CopperPilot/rpi-zero-2w-kicad/docs/images/kicad-3d-isometric.png

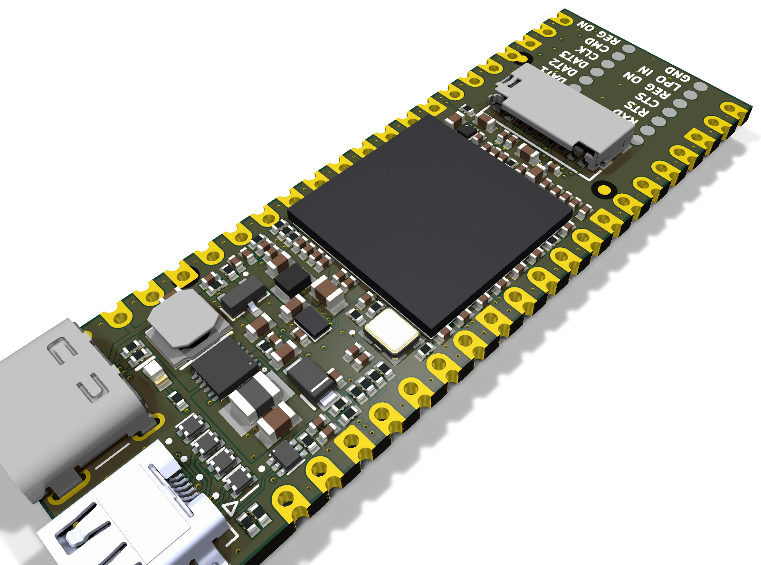
docs/images/kicad-3d-isometric.png
