CopperPilot/rpi-zero-2w-kicad/docs/images/kicad-3d-top-dnp.png

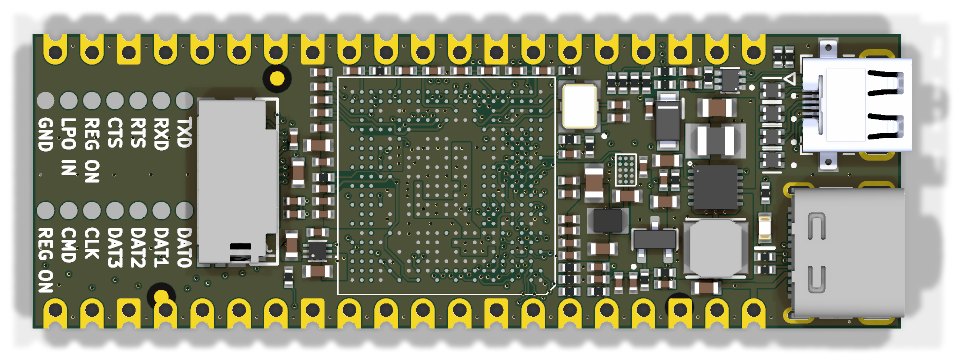
docs/images/kicad-3d-top-dnp.png
