CopperPilot/rpi-zero-2w-kicad/pcb/jlcpcb/rp3a0-mini-bom.csv

Comment | Designator | Footprint | JLCPCB Part #（optional）
220n | C1,C2,C5,C8,C18,C20,C21,C22,C23,C24,C26,C27,C28,C29,C30,C31,C32,C33,C34,C35,C37,C39,C40,C41,C42,C44,C45,C46 | 0402 | C16772
10u | C3,C4,C11,C13,C16,C17 | 0603 | C96446
30p | C6,C9 | 0402 | C1570
1u | C7,C10 | 0402 | C52923
47u | C12,C14 | C0805_NP | C16780
100n | C15,C19,C47 | 0402 | C1525
100p | C25 | 0402 | C1546
4.7u | C36,C38,C43 | 0603 | C1705
LED_GREEN | D1 | LED_0603 | C12624
DFLS130L-7 | D2 | DIO_DFLS130LQ-7 | C110493
EXC24CH900U | FL1,FL2,FL3,FL4 | FIL_EXC24CB102U | C236275
473092651 | J1 | MOLEX_0475710001 | C587826
467652301 | J2 | MOLEX_467652301 | C6961796
1054500101 | J3 | MOLEX_105450-0101 | C134092
470nH | L1 | INDC2016X100N | C89446
4.7uH | L2 | INDP4040X180N | C5926030
2.2uH | L3 | INDP2622X120N | C2041574
220R | L4,L5,L6 | 0402 | C85813
DMG2305UX-7 | Q1 | SOT91P240X110-3N_DMG2305UX-7 | C150470
1.8k | R1,R2,R21,R22,R23,R24 | RES-0402-SML | C25871
100k | R3,R19,R20 | RES-0402-SML | C25741
470k | R4 | RES-0402-SML | C25790
82k | R5 | RES-0402-SML | C4142
10k | R6 | RES-0402-SML | C25744
47k | R7,R15,R25 | RES-0402-SML | C25792
18k | R8 | RES-0402-SML | C25762
5.1k | R9,R10 | RES-0402-SML | C25905
470R | R11 | RES-0402-SML | C25117
240R | R12,R13,R18 | RES-0402-SML | C114755
33R | R14 | RES-0402-SML | C25105
3.9k | R16 | RES-0402-SML | C51721
1k | R17 | RES-0402-SML | C11702
NCP133AMX125TCG | U2 | VREG_RT9081A_1BGQZA_2 | C603545
RT8088AWSC | U3 | 15B_WLCSP_1.31X2.11 | C5739348
PAM2306AYPKE | U4 | SON45P300X300X80-13N | C508236
DMN601VK-7 | U5 | SOT50P162X60-6N | C110498
19.2MHz | Y1 | XTAL_ECS-192-18-33-JGN-TR | C5380596
