CopperPilot/rpi-zero-2w-kicad/pcb/rp3a0-mini.kicad_pcb

## KiCad design pcb/rp3a0-mini.kicad_pcb (2026-10-23)

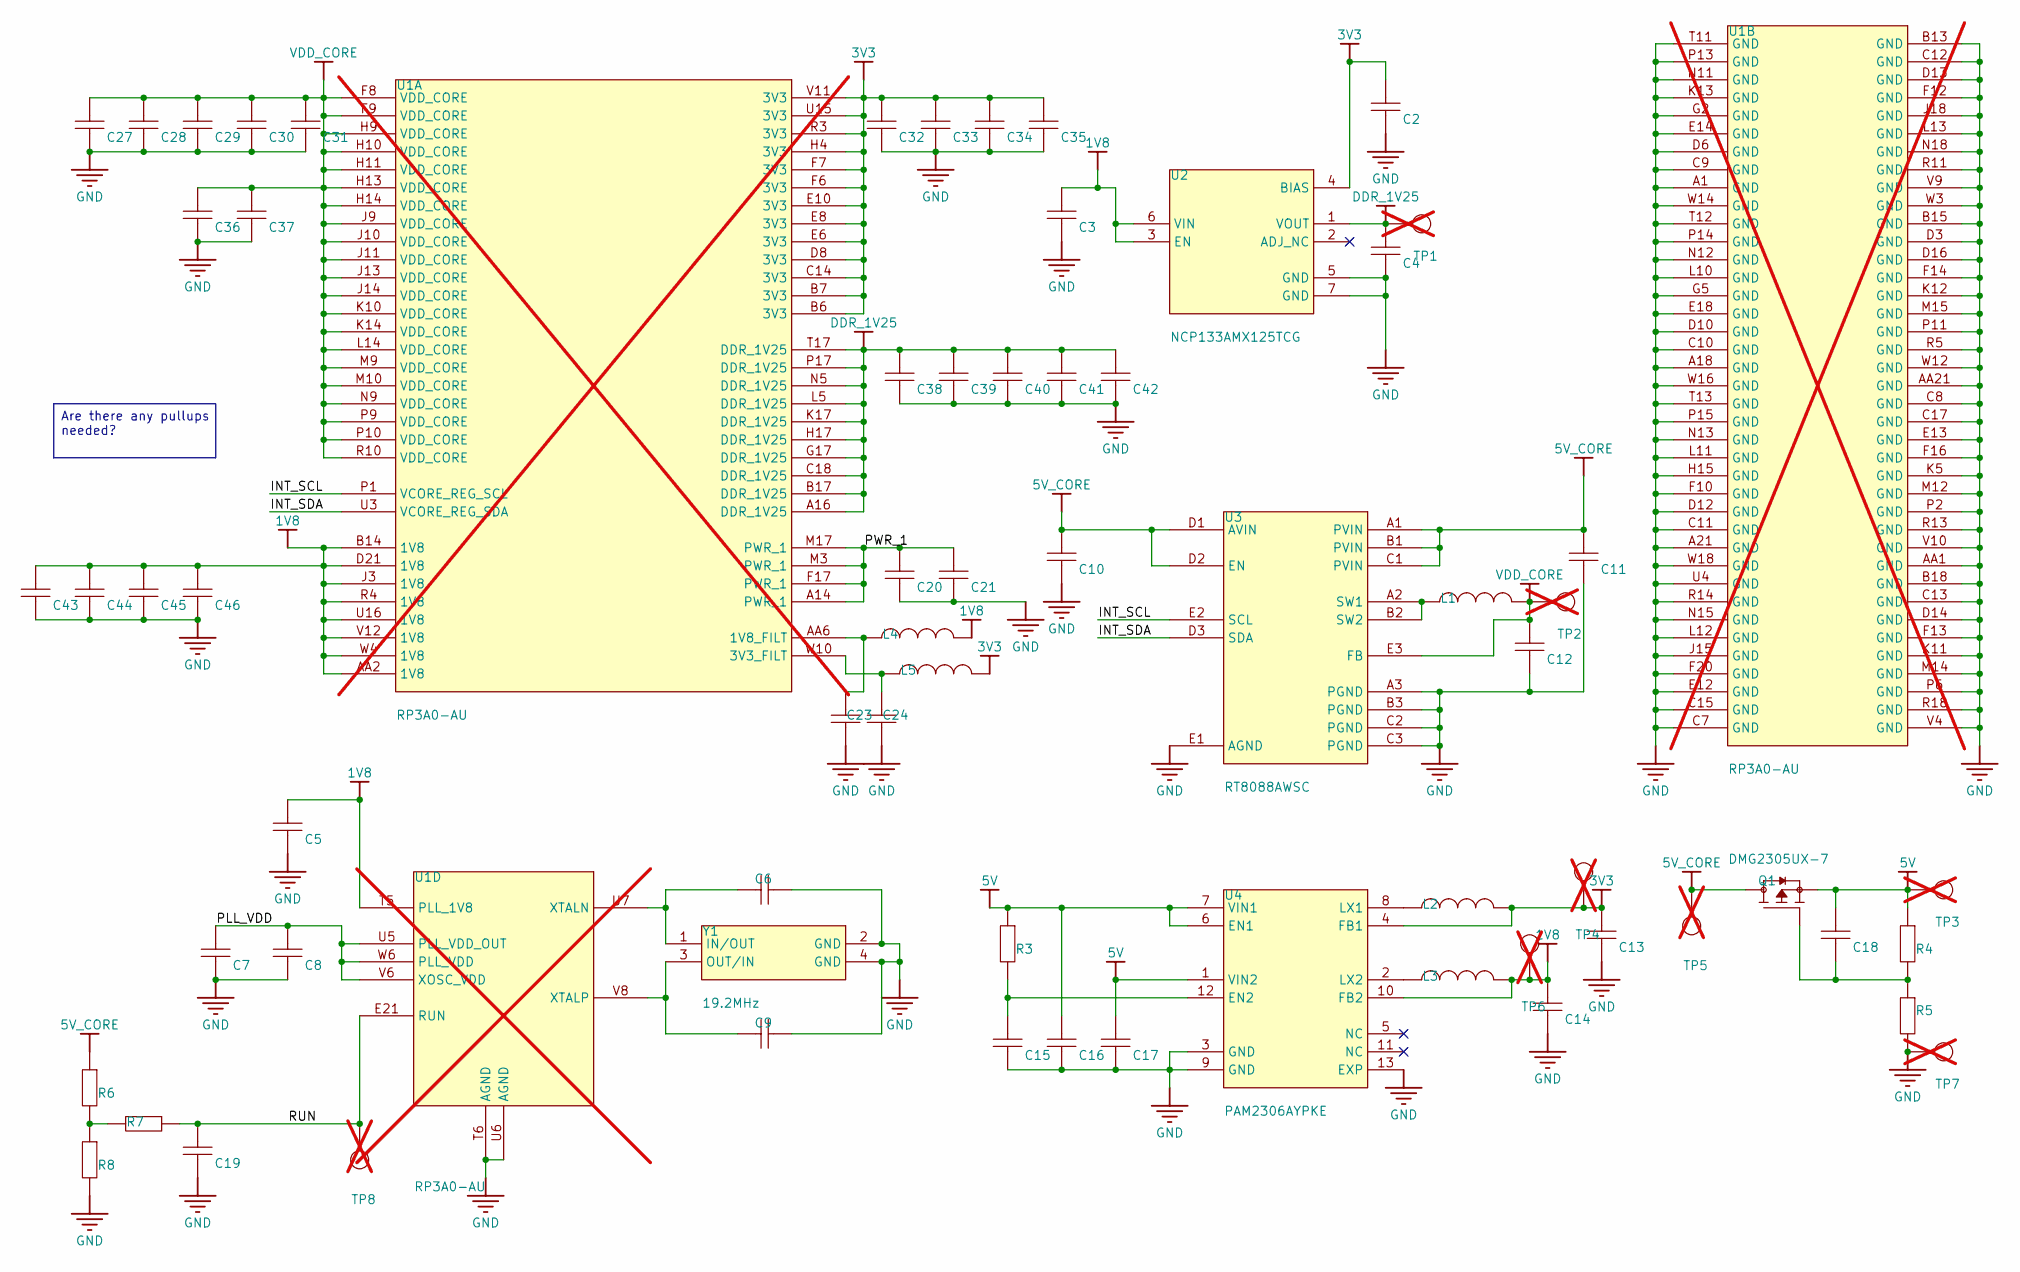
[picture p8: schematic rp3a-mini-power.kicad_sch, RP3A0 Pico - Power]

Parts:
C2, C5, C8, C18, C20, C21, C23, C24, C27, C28, C29, C30, C31, C32, C33, C34, C35, C37, C39, C40, C41, C42, C44, C45, C46: 220n; 0402; MPN CL05B224KO5NNNC; LCSC C16772
C3, C4, C11, C13, C16, C17: 10u; 0603; MPN CL10A106MA8NRNC; LCSC C96446
C6, C9: 30p; 0402; MPN 0402CG300J500NT; LCSC C1570
C7, C10: 1u; 0402; MPN CL05A105KA5NQNC; LCSC C52923
C12, C14: 47u; C0805_NP; MPN CL21A476MQYNNNE; LCSC C16780
C15, C19: 100n; 0402; MPN CL05B104KO5NNNC; LCSC C1525
C36, C38, C43: 4.7u; 0603; MPN CL10A475KP8NNNC; LCSC C1705
L1: 470nH; INDC2016X100N; MPN TFM201610GHM-R47MTAA; LCSC C89446
L2: 4.7uH; INDP4040X180N; MPN SRN4030HA-4R7Y; LCSC C5926030
L3: 2.2uH; INDP2622X120N; MPN SRN2512-2R2M; LCSC C2041574
L4, L5: 220R; 0402; MPN BLM15AG221SN1D; LCSC C85813
Q1: DMG2305UX-7; SOT91P240X110-3N_DMG2305UX-7; MPN DMG2305UX-7; LCSC C150470
R3: 100k; RES-0402-SML; MPN 0402WGF1003TCE; LCSC C25741
R4: 470k; RES-0402-SML; MPN 0402WGF4703TCE; LCSC C25790
R5: 82k; RES-0402-SML; MPN 0402WGF8202TCE; LCSC C4142
R6: 10k; RES-0402-SML; MPN 0402WGF1002TCE; LCSC C25744
R7: 47k; RES-0402-SML; MPN 0402WGF4702TCE; LCSC C25792
R8: 18k; RES-0402-SML; MPN 0402WGF1802TCE; LCSC C25762
TP1, TP2, TP3, TP4, TP5, TP6, TP7, TP8: TEST_POINT; TEST_POINT_1.2MM; MPN TEST_POINT_1.2MM; not fitted
U1: RP3A0-AU; RP3A0-BGA; MPN RP3A0-AU; not fitted
U2: NCP133AMX125TCG; VREG_RT9081A_1BGQZA_2; MPN NCP133AMX125TCG; LCSC C603545
U3: RT8088AWSC; 15B_WLCSP_1.31X2.11; MPN RT8088AWSC; LCSC C5739348
U4: PAM2306AYPKE; SON45P300X300X80-13N; MPN PAM2306AYPKE; LCSC C508236
Y1: 19.2MHz; XTAL_ECS-192-18-33-JGN-TR; MPN S3219200182080C3; LCSC C5380596

Connections:
1V8: C3.2, C5.2, C14.2, C43.2, C44.2, C45.2, C46.2, L3.2, L4.2, TP6.TP, U1.AA2 (1V8), U1.B14 (1V8), U1.D21 (1V8), U1.J3 (1V8), U1.R4 (1V8), U1.T5 (PLL_1V8), U1.U16 (1V8), U1.V12 (1V8), U1.W4 (1V8), U2.3 (EN), U2.6 (VIN), U4.10 (FB2)
3V3: C2.2, C13.2, C32.2, C33.2, C34.2, C35.2, L2.2, L5.2, TP4.TP, U1.B6 (3V3), U1.B7 (3V3), U1.C14 (3V3), U1.D8 (3V3), U1.E6 (3V3), U1.E8 (3V3), U1.E10 (3V3), U1.F6 (3V3), U1.F7 (3V3), U1.H4 (3V3), U1.R3 (3V3), U1.U15 (3V3), U1.V11 (3V3), U2.4 (BIAS), U4.4 (FB1); also elsewhere on the board
5V: C16.2, C17.2, C18.2, Q1.2 (S), R3.2, R4.2, TP3.TP, U4.1 (VIN2), U4.6 (EN1), U4.7 (VIN1); also elsewhere on the board
5V_CORE: C10.2, C11.2, Q1.3 (D), R6.2, TP5.TP, U3.A1 (PVIN), U3.B1 (PVIN), U3.C1 (PVIN), U3.D1 (AVIN), U3.D2 (EN)
/Power/INT_SCL: U1.P1 (VCORE_REG_SCL), U3.E2 (SCL)
/Power/INT_SDA: U1.U3 (VCORE_REG_SDA), U3.D3 (SDA)
/Power/PLL_VDD: C7.2, C8.2, U1.U5 (PLL_VDD_OUT), U1.V6 (XOSC_VDD), U1.W6 (PLL_VDD)
/Power/PWR_1: C20.2, C21.2, U1.A14 (PWR_1), U1.F17 (PWR_1), U1.M3 (PWR_1), U1.M17 (PWR_1)
/Power/RUN: C19.2, R7.2, TP8.TP, U1.E21 (RUN)
DDR_1V25: C4.2, C38.2, C39.2, C40.2, C41.2, C42.2, TP1.TP, U1.A16 (DDR_1V25), U1.B17 (DDR_1V25), U1.C18 (DDR_1V25), U1.G17 (DDR_1V25), U1.H17 (DDR_1V25), U1.K17 (DDR_1V25), U1.L5 (DDR_1V25), U1.N5 (DDR_1V25), U1.P17 (DDR_1V25), U1.T17 (DDR_1V25), U2.1 (VOUT)
GND: C2.1, C3.1, C4.1, C5.1, C6.2, C7.1, C8.1, C9.2, C10.1, C11.1, C12.1, C13.1, C14.1, C15.1, C16.1, C17.1, C19.1, C20.1, C21.1, C23.1, C24.1, C27.1, C28.1, C29.1, C30.1, C31.1, C32.1, C33.1, C34.1, C35.1, C36.1, C37.1, C38.1, C39.1, C40.1, C41.1, C42.1, C43.1, C44.1, C45.1, C46.1, R5.2, R8.1, TP7.TP, U1.A1 (GND), U1.A18 (GND), U1.A21 (GND), U1.AA1 (GND), U1.AA21 (GND), U1.B13 (GND), U1.B15 (GND), U1.B18 (GND), U1.C7 (GND), U1.C8 (GND), U1.C9 (GND), U1.C10 (GND), U1.C11 (GND), U1.C12 (GND), U1.C13 (GND), U1.C15 (GND), U1.C17 (GND), U1.D3 (GND), U1.D6 (GND), U1.D10 (GND), U1.D12 (GND), U1.D13 (GND), U1.D14 (GND), U1.D16 (GND), U1.E12 (GND), U1.E13 (GND), U1.E14 (GND), U1.E18 (GND), U1.F10 (GND), U1.F12 (GND), U1.F13 (GND), U1.F14 (GND), U1.F16 (GND), U1.F20 (GND), U1.G2 (GND), U1.G5 (GND), U1.H15 (GND), U1.J15 (GND), U1.J18 (GND), U1.K5 (GND), U1.K11 (GND), U1.K12 (GND), U1.K13 (GND), U1.L10 (GND), U1.L11 (GND), U1.L12 (GND), U1.L13 (GND), U1.M12 (GND), U1.M14 (GND), U1.M15 (GND), U1.N11 (GND), U1.N12 (GND), U1.N13 (GND), U1.N15 (GND), U1.N18 (GND), U1.P2 (GND), U1.P6 (GND), U1.P11 (GND), U1.P13 (GND), U1.P14 (GND), U1.P15 (GND), U1.R5 (GND), U1.R11 (GND), U1.R13 (GND), U1.R14 (GND), U1.R18 (GND), U1.T6 (AGND), U1.T11 (GND), U1.T12 (GND), U1.T13 (GND), U1.U4 (GND), U1.U6 (AGND), U1.V4 (GND), U1.V9 (GND), U1.V10 (GND), U1.W3 (GND), U1.W12 (GND), U1.W14 (GND), U1.W16 (GND), U1.W18 (GND), U2.5 (GND), U2.7 (GND), U3.A3 (PGND), U3.B3 (PGND), U3.C2 (PGND), U3.C3 (PGND), U3.E1 (AGND), U4.3 (GND), U4.9 (GND), U4.13 (EXP), Y1.2 (GND), Y1.4 (GND); also elsewhere on the board
unnamed: C18.1, Q1.1 (G), R4.1, R5.1
unnamed: R6.1, R7.1, R8.2
unnamed: C23.2, L4.1, U1.AA6 (1V8_FILT)
unnamed: C24.2, L5.1, U1.W10 (3V3_FILT)
unnamed: C6.1, U1.U7 (XTALN), Y1.1 (IN/OUT)
unnamed: C9.1, U1.V8 (XTALP), Y1.3 (OUT/IN)
unnamed: L1.1, U3.A2 (SW1), U3.B2 (SW2)
unnamed: C15.2, R3.1, U4.12 (EN2)
unnamed: L2.1, U4.8 (LX1)
unnamed: L3.1, U4.2 (LX2)
VDD_CORE: C12.2, C27.2, C28.2, C29.2, C30.2, C31.2, C36.2, C37.2, L1.2, TP2.TP, U1.F8 (VDD_CORE), U1.F9 (VDD_CORE), U1.H9 (VDD_CORE), U1.H10 (VDD_CORE), U1.H11 (VDD_CORE), U1.H13 (VDD_CORE), U1.H14 (VDD_CORE), U1.J9 (VDD_CORE), U1.J10 (VDD_CORE), U1.J11 (VDD_CORE), U1.J13 (VDD_CORE), U1.J14 (VDD_CORE), U1.K10 (VDD_CORE), U1.K14 (VDD_CORE), U1.L14 (VDD_CORE), U1.M9 (VDD_CORE), U1.M10 (VDD_CORE), U1.N9 (VDD_CORE), U1.P9 (VDD_CORE), U1.P10 (VDD_CORE), U1.R10 (VDD_CORE), U3.E3 (FB)

Notes on the sheet:
Are there any pullups needed?

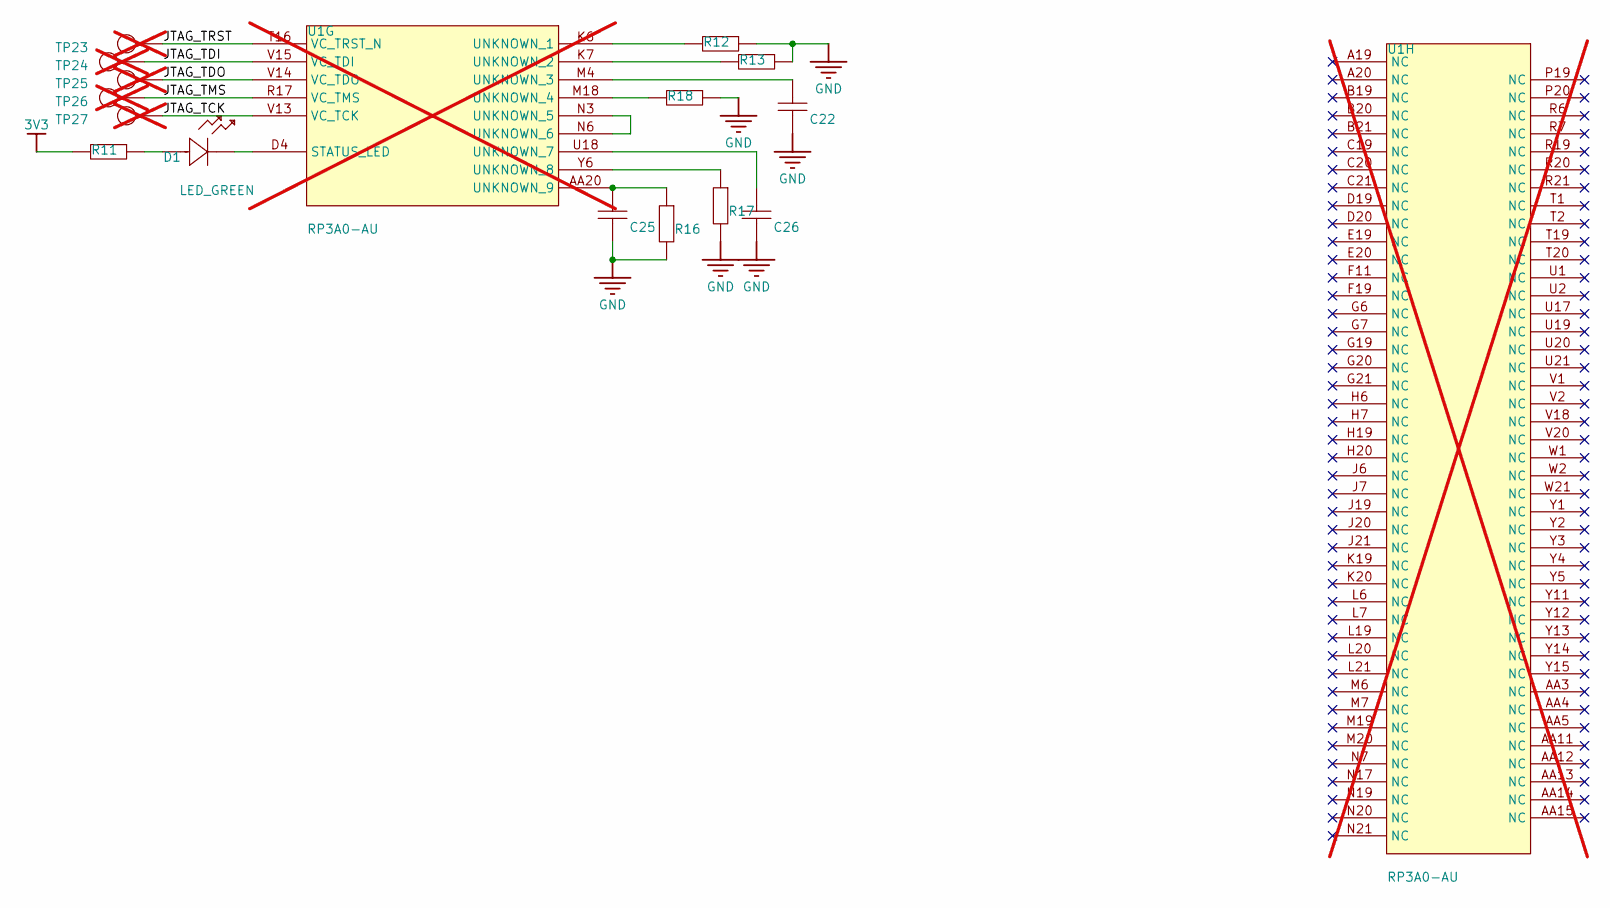
[picture p9: schematic rp3a0-mini-misc.kicad_sch, RP3A0 Pico - Misc_JTAG]

Parts:
C22, C26: 220n; 0402; MPN CL05B224KO5NNNC; LCSC C16772
C25: 100p; 0402; MPN 0402CG101J500NT; LCSC C1546
D1: LED_GREEN; LED_0603; MPN KT-0603G; LCSC C12624
R11: 470R; RES-0402-SML; MPN 0402WGF4700TCE; LCSC C25117
R12, R13, R18: 240R; RES-0402-SML; MPN RC0402FR-07240RL; LCSC C114755
R16: 3.9k; RES-0402-SML; MPN 0402WGF3901TCE; LCSC C51721
R17: 1k; RES-0402-SML; MPN 0402WGF1001TCE; LCSC C11702
TP23, TP24, TP25, TP26, TP27: TEST_POINT; TEST_POINT_1.2MM; MPN TEST_POINT_1.2MM; not fitted
U1: RP3A0-AU; RP3A0-BGA; MPN RP3A0-AU; not fitted

Connections:
3V3: R11.1; also elsewhere on the board
/Misc_JTAG/JTAG_TCK: TP27.TP, U1.V13 (VC_TCK)
/Misc_JTAG/JTAG_TDI: TP24.TP, U1.V15 (VC_TDI)
/Misc_JTAG/JTAG_TDO: TP25.TP, U1.V14 (VC_TDO)
/Misc_JTAG/JTAG_TMS: TP26.TP, U1.R17 (VC_TMS)
/Misc_JTAG/JTAG_TRST: TP23.TP, U1.T16 (VC_TRST_N)
GND: C22.1, C25.1, C26.1, R12.2, R13.2, R16.1, R17.1, R18.2; also elsewhere on the board
unnamed: D1.2, R11.2
unnamed: D1.1, U1.D4 (STATUS_LED)
unnamed: R12.1, U1.K6 (UNKNOWN_1)
unnamed: R13.1, U1.K7 (UNKNOWN_2)
unnamed: C22.2, U1.M4 (UNKNOWN_3)
unnamed: R18.1, U1.M18 (UNKNOWN_4)
unnamed: U1.N3 (UNKNOWN_5), U1.N6 (UNKNOWN_6)
unnamed: C26.2, U1.U18 (UNKNOWN_7)
unnamed: R17.2, U1.Y6 (UNKNOWN_8)
unnamed: C25.2, R16.2, U1.AA20 (UNKNOWN_9)

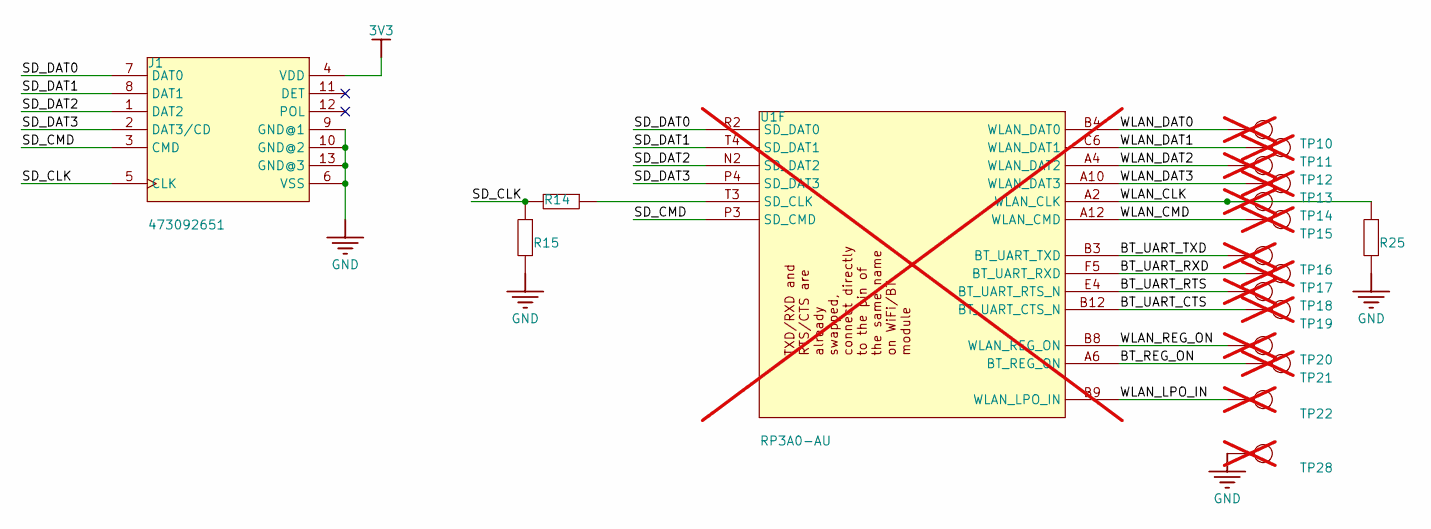
[picture p10: schematic rp3a0-mini-wireless-sd.kicad_sch, RP3A0 Pico - Wireless_SD]

Parts:
J1: 473092651; MOLEX_0475710001; MPN 473092651; LCSC C587826
R14: 33R; RES-0402-SML; MPN 0402WGF330JTCE; LCSC C25105
R15, R25: 47k; RES-0402-SML; MPN 0402WGF4702TCE; LCSC C25792
TP10, TP11, TP12, TP13, TP14, TP15, TP16, TP17, TP18, TP19, TP20, TP21, TP22, TP28: TEST_POINT; TEST_POINT_1.2MM; MPN TEST_POINT_1.2MM; not fitted
U1: RP3A0-AU; RP3A0-BGA; MPN RP3A0-AU; not fitted

Connections:
3V3: J1.4 (VDD); also elsewhere on the board
/Wireless_SD/BT_REG_ON: TP21.TP, U1.A6 (BT_REG_ON)
/Wireless_SD/BT_UART_CTS: TP19.TP, U1.B12 (BT_UART_CTS_N)
/Wireless_SD/BT_UART_RTS: TP18.TP, U1.E4 (BT_UART_RTS_N)
/Wireless_SD/BT_UART_RXD: TP17.TP, U1.F5 (BT_UART_RXD)
/Wireless_SD/BT_UART_TXD: TP16.TP, U1.B3 (BT_UART_TXD)
/Wireless_SD/SD_CLK: J1.5 (CLK), R14.1, R15.2
/Wireless_SD/SD_CMD: J1.3 (CMD), U1.P3 (SD_CMD)
/Wireless_SD/SD_DAT0: J1.7 (DAT0), U1.R2 (SD_DAT0)
/Wireless_SD/SD_DAT1: J1.8 (DAT1), U1.T4 (SD_DAT1)
/Wireless_SD/SD_DAT2: J1.1 (DAT2), U1.N2 (SD_DAT2)
/Wireless_SD/SD_DAT3: J1.2 (DAT3/CD), U1.P4 (SD_DAT3)
/Wireless_SD/WLAN_CLK: R25.2, TP14.TP, U1.A2 (WLAN_CLK)
/Wireless_SD/WLAN_CMD: TP15.TP, U1.A12 (WLAN_CMD)
/Wireless_SD/WLAN_DAT0: TP10.TP, U1.B4 (WLAN_DAT0)
/Wireless_SD/WLAN_DAT1: TP11.TP, U1.C6 (WLAN_DAT1)
/Wireless_SD/WLAN_DAT2: TP12.TP, U1.A4 (WLAN_DAT2)
/Wireless_SD/WLAN_DAT3: TP13.TP, U1.A10 (WLAN_DAT3)
/Wireless_SD/WLAN_LPO_IN: TP22.TP, U1.B9 (WLAN_LPO_IN)
/Wireless_SD/WLAN_REG_ON: TP20.TP, U1.B8 (WLAN_REG_ON)
GND: J1.6 (VSS), J1.9 (GND@1), J1.10 (GND@2), J1.13 (GND@3), R15.1, R25.1, TP28.TP; also elsewhere on the board
unnamed: R14.2, U1.T3 (SD_CLK)

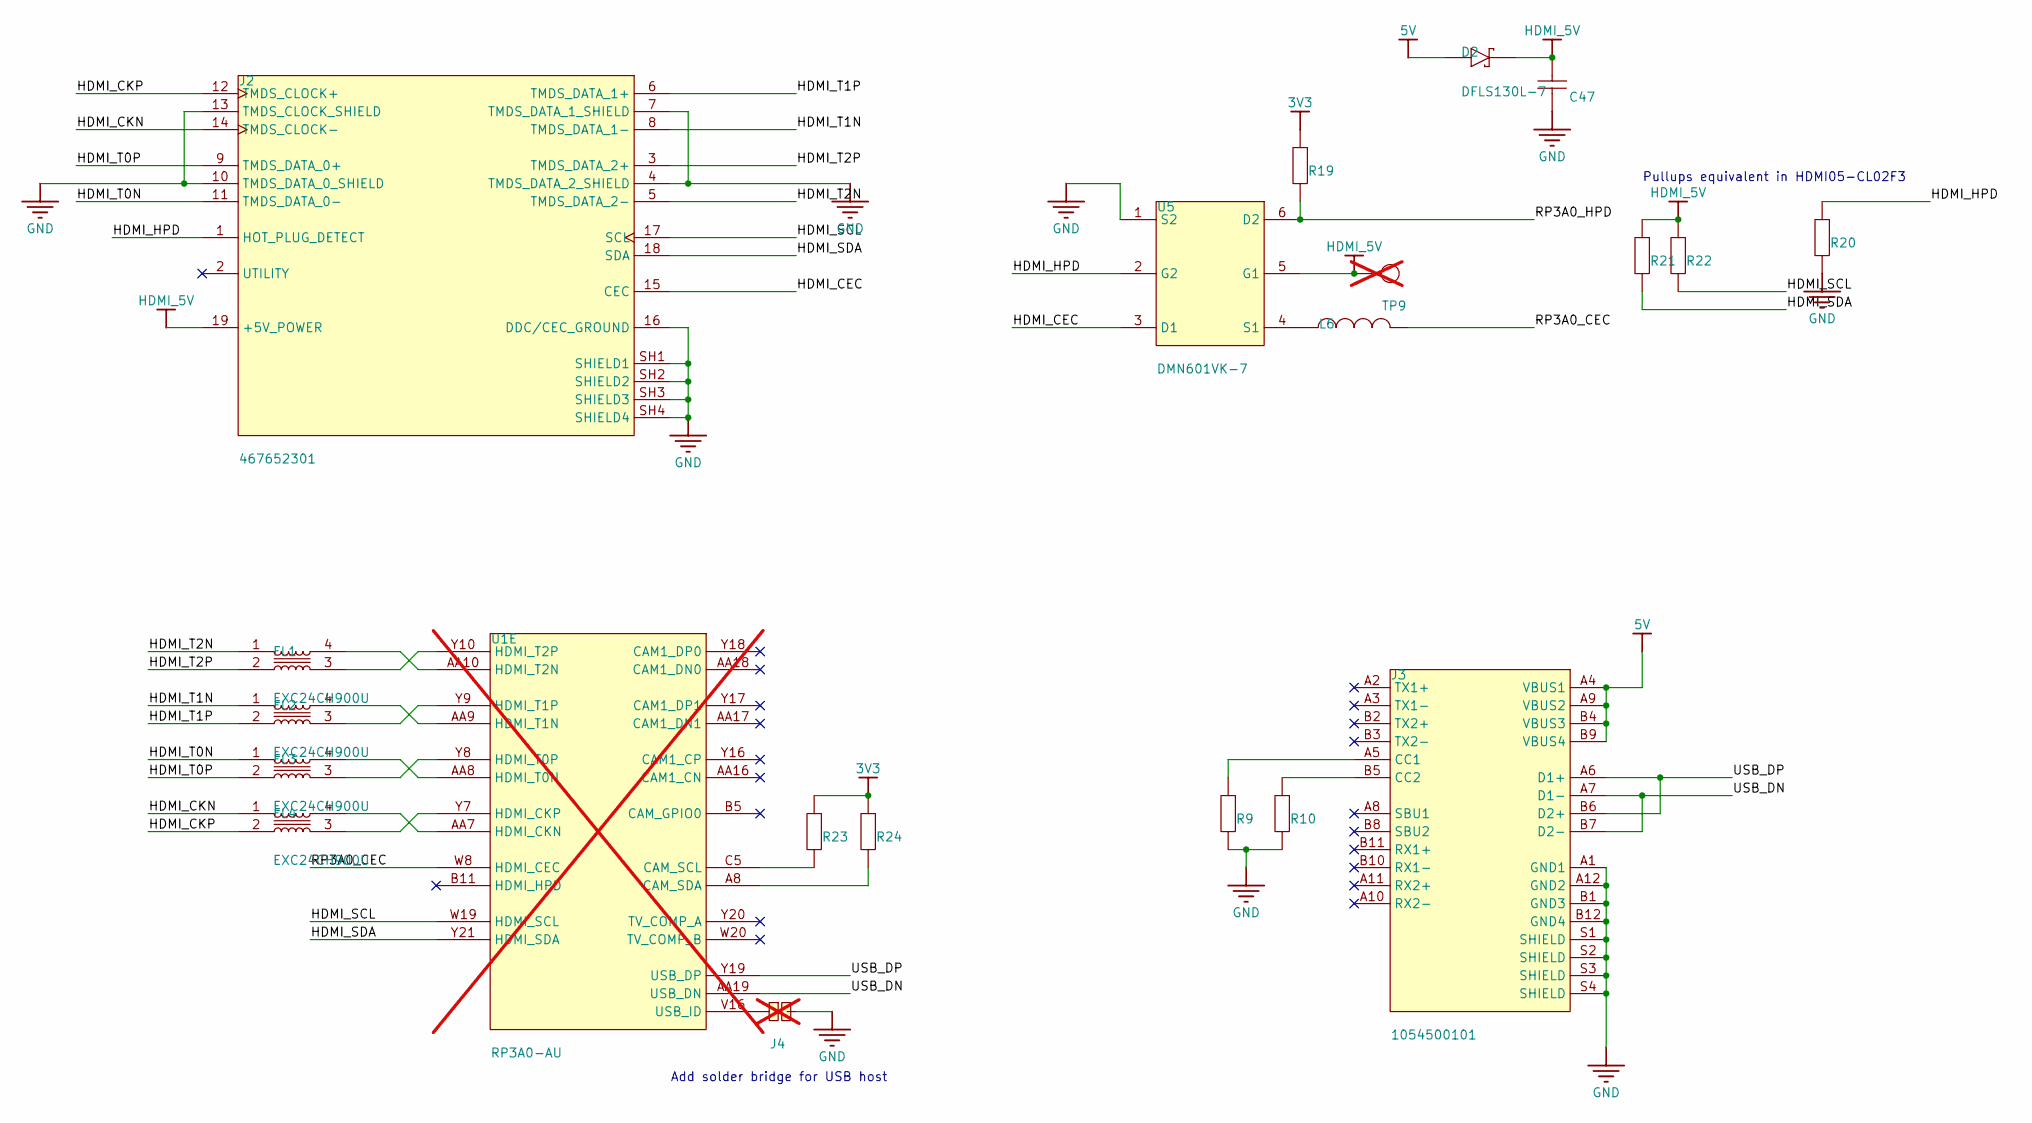
[picture p11: schematic rp3a0-mini-hdmi.kicad_sch, RP3A0 Pico - HDMI_USB]

Parts:
C47: 100n; 0402; MPN CL05B104KO5NNNC; LCSC C1525
D2: DFLS130L-7; DIO_DFLS130LQ-7; MPN DFLS130L-7; LCSC C110493
FL1, FL2, FL3, FL4: EXC24CH900U; FIL_EXC24CB102U; MPN EXC24CH900U; LCSC C236275
J2: 467652301; MOLEX_467652301; MPN 467652301; LCSC C6961796
J3: 1054500101; MOLEX_105450-0101; MPN 1054500101; DIGI-KEY_PART_NUMBER WM12856CT-ND
J4: SOLDER_PAD_OPEN; MPN SOLDER_PAD_OPEN; not fitted
L6: 220R; 0402; MPN BLM15AG221SN1D; LCSC C85813
R9, R10: 5.1k; RES-0402-SML; MPN 0402WGF5101TCE; LCSC C25905
R19, R20: 100k; RES-0402-SML; MPN 0402WGF1003TCE; LCSC C25741
R21, R22, R23, R24: 1.8k; RES-0402-SML; MPN 0402WGF1801TCE; LCSC C25871
TP9: TEST_POINT; TEST_POINT_1.2MM; MPN TEST_POINT_1.2MM; not fitted
U1: RP3A0-AU; RP3A0-BGA; MPN RP3A0-AU; not fitted
U5: DMN601VK-7; SOT50P162X60-6N; MPN DMN601VK-7; LCSC C110498

Connections:
3V3: R19.2, R23.2, R24.2; also elsewhere on the board
5V: D2.A, J3.A4 (VBUS1), J3.A9 (VBUS2), J3.B4 (VBUS3), J3.B9 (VBUS4); also elsewhere on the board
/HDMI_USB/HDMI_CEC: J2.15 (CEC), U5.3 (D1)
/HDMI_USB/HDMI_CKN: FL4.1, J2.14 (TMDS_CLOCK-)
/HDMI_USB/HDMI_CKP: FL4.2, J2.12 (TMDS_CLOCK+)
/HDMI_USB/HDMI_HPD: J2.1 (HOT_PLUG_DETECT), R20.2, U5.2 (G2)
/HDMI_USB/HDMI_SCL: J2.17 (SCL), R22.1, U1.W19 (HDMI_SCL)
/HDMI_USB/HDMI_SDA: J2.18 (SDA), R21.1, U1.Y21 (HDMI_SDA)
/HDMI_USB/HDMI_T0N: FL3.1, J2.11 (TMDS_DATA_0-)
/HDMI_USB/HDMI_T0P: FL3.2, J2.9 (TMDS_DATA_0+)
/HDMI_USB/HDMI_T1N: FL2.1, J2.8 (TMDS_DATA_1-)
/HDMI_USB/HDMI_T1P: FL2.2, J2.6 (TMDS_DATA_1+)
/HDMI_USB/HDMI_T2N: FL1.1, J2.5 (TMDS_DATA_2-)
/HDMI_USB/HDMI_T2P: FL1.2, J2.3 (TMDS_DATA_2+)
/HDMI_USB/RP3A0_CEC: L6.2, U1.W8 (HDMI_CEC)
/HDMI_USB/RP3A0_HPD: R19.1, U5.6 (D2)
/HDMI_USB/USB_DN: J3.A7 (D1-), J3.B7 (D2-), U1.AA19 (USB_DN)
/HDMI_USB/USB_DP: J3.A6 (D1+), J3.B6 (D2+), U1.Y19 (USB_DP)
GND: C47.1, J2.4 (TMDS_DATA_2_SHIELD), J2.7 (TMDS_DATA_1_SHIELD), J2.10 (TMDS_DATA_0_SHIELD), J2.13 (TMDS_CLOCK_SHIELD), J2.16 (DDC/CEC_GROUND), J2.SH1 (SHIELD1), J2.SH2 (SHIELD2), J2.SH3 (SHIELD3), J2.SH4 (SHIELD4), J3.A1 (GND1), J3.A12 (GND2), J3.B1 (GND3), J3.B12 (GND4), J3.S1 (SHIELD), J3.S2 (SHIELD), J3.S3 (SHIELD), J3.S4 (SHIELD), J4.2, R9.1, R10.1, R20.1, U5.1 (S2); also elsewhere on the board
HDMI_5V: C47.2, D2.K, J2.19 (+5V_POWER), R21.2, R22.2, TP9.TP, U5.5 (G1)
unnamed: J3.A5 (CC1), R9.2
unnamed: J3.B5 (CC2), R10.2
unnamed: R23.1, U1.C5 (CAM_SCL)
unnamed: R24.1, U1.A8 (CAM_SDA)
unnamed: FL4.4, U1.AA7 (HDMI_CKN)
unnamed: FL4.3, U1.Y7 (HDMI_CKP)
unnamed: FL3.4, U1.AA8 (HDMI_T0N)
unnamed: FL3.3, U1.Y8 (HDMI_T0P)
unnamed: FL2.4, U1.AA9 (HDMI_T1N)
unnamed: FL2.3, U1.Y9 (HDMI_T1P)
unnamed: FL1.4, U1.AA10 (HDMI_T2N)
unnamed: FL1.3, U1.Y10 (HDMI_T2P)
unnamed: J4.1, U1.V16 (USB_ID)
unnamed: L6.1, U5.4 (S1)

Notes on the sheet:
Pullups equivalent in HDMI05-CL02F3
Add solder bridge for USB host

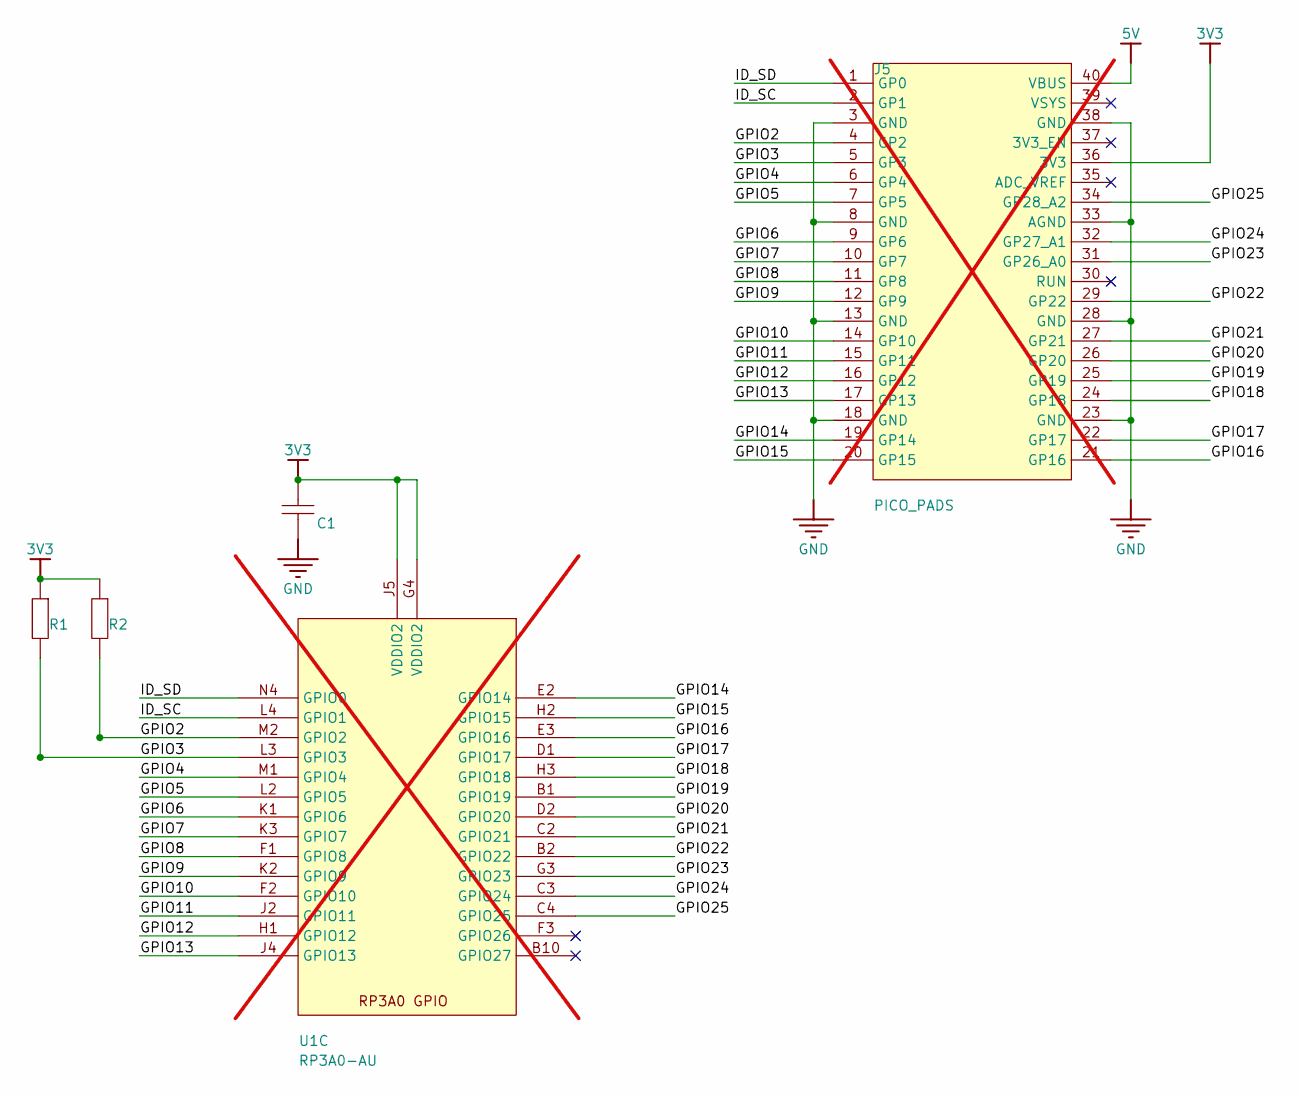
[picture p12: schematic rp3a0-mini-gpio.kicad_sch, RP3A0 Pico - GPIO]

Parts:
C1: 220n; 0402; MPN CL05B224KO5NNNC; LCSC C16772
J5: PICO_PADS; MPN PICO_PADS; not fitted
R1, R2: 1.8k; RES-0402-SML; MPN 0402WGF1801TCE; LCSC C25871
U1: RP3A0-AU; RP3A0-BGA; MPN RP3A0-AU; not fitted

Connections:
3V3: C1.2, J5.36 (3V3), R1.2, R2.2, U1.G4 (VDDIO2), U1.J5 (VDDIO2); also elsewhere on the board
5V: J5.40 (VBUS); also elsewhere on the board
/GPIO/GPIO2: J5.4 (GP2), R2.1, U1.M2 (GPIO2)
/GPIO/GPIO3: J5.5 (GP3), R1.1, U1.L3 (GPIO3)
/GPIO/GPIO4: J5.6 (GP4), U1.M1 (GPIO4)
/GPIO/GPIO5: J5.7 (GP5), U1.L2 (GPIO5)
/GPIO/GPIO6: J5.9 (GP6), U1.K1 (GPIO6)
/GPIO/GPIO7: J5.10 (GP7), U1.K3 (GPIO7)
/GPIO/GPIO8: J5.11 (GP8), U1.F1 (GPIO8)
/GPIO/GPIO9: J5.12 (GP9), U1.K2 (GPIO9)
/GPIO/GPIO10: J5.14 (GP10), U1.F2 (GPIO10)
/GPIO/GPIO11: J5.15 (GP11), U1.J2 (GPIO11)
/GPIO/GPIO12: J5.16 (GP12), U1.H1 (GPIO12)
/GPIO/GPIO13: J5.17 (GP13), U1.J4 (GPIO13)
/GPIO/GPIO14: J5.19 (GP14), U1.E2 (GPIO14)
/GPIO/GPIO15: J5.20 (GP15), U1.H2 (GPIO15)
/GPIO/GPIO16: J5.21 (GP16), U1.E3 (GPIO16)
/GPIO/GPIO17: J5.22 (GP17), U1.D1 (GPIO17)
/GPIO/GPIO18: J5.24 (GP18), U1.H3 (GPIO18)
/GPIO/GPIO19: J5.25 (GP19), U1.B1 (GPIO19)
/GPIO/GPIO20: J5.26 (GP20), U1.D2 (GPIO20)
/GPIO/GPIO21: J5.27 (GP21), U1.C2 (GPIO21)
/GPIO/GPIO22: J5.29 (GP22), U1.B2 (GPIO22)
/GPIO/GPIO23: J5.31 (GP26_A0), U1.G3 (GPIO23)
/GPIO/GPIO24: J5.32 (GP27_A1), U1.C3 (GPIO24)
/GPIO/GPIO25: J5.34 (GP28_A2), U1.C4 (GPIO25)
/GPIO/ID_SC: J5.2 (GP1), U1.L4 (GPIO1)
/GPIO/ID_SD: J5.1 (GP0), U1.N4 (GPIO0)
GND: C1.1, J5.3 (GND), J5.8 (GND), J5.13 (GND), J5.18 (GND), J5.23 (GND), J5.28 (GND), J5.33 (AGND), J5.38 (GND); also elsewhere on the board

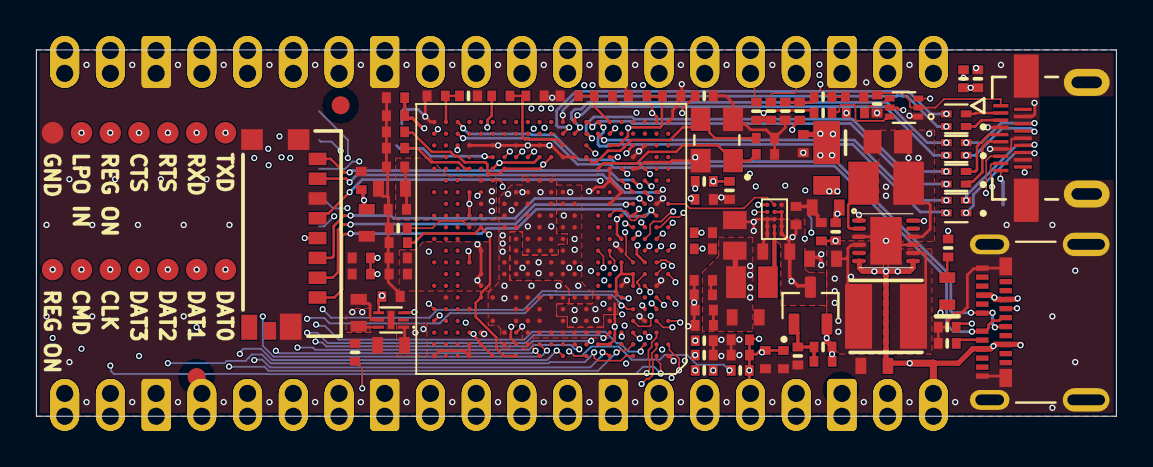
[picture p13: board rp3a0-mini.kicad_pcb from above]

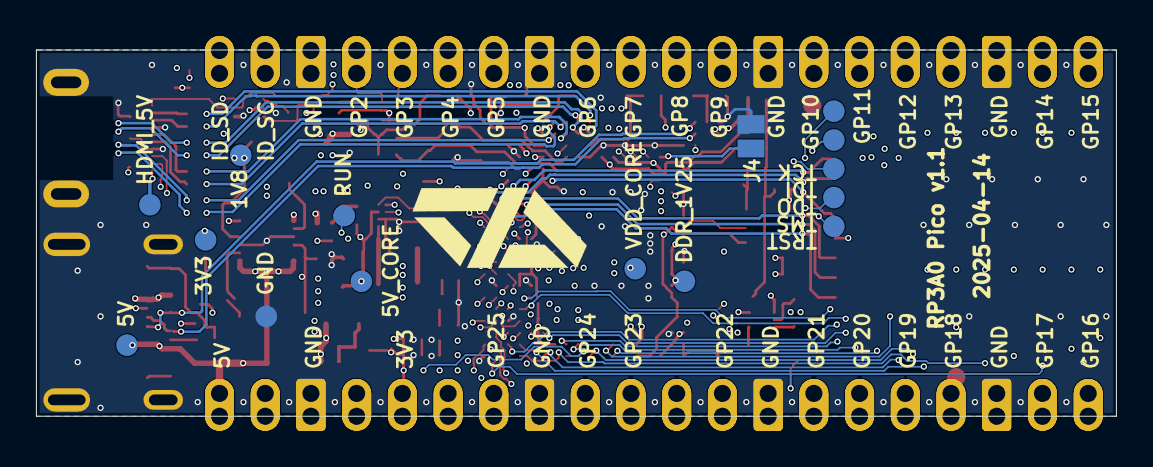
[picture p14: board rp3a0-mini.kicad_pcb from below]

Board: 6 copper layers, 60.0 x 20.4 mm, 124 parts (15 on the bottom side), 114 nets.
