CopperPilot/rpi-zero-2w-kicad/(commit log)

2026-10-20 chore: scaffold repository Makefiles and gitignore for RP3A0 KiCad port
    Add root and pcb Makefiles modeled after CopperPilotDronePCB with ERC, DRC, PyTest, and copper-pilot validate targets.
2026-10-20 feat(pcb): translate RP3A0 Pico Altium project to KiCad 10 for JLCPCB 6-layer fab
    Import and normalize 6-sheet hierarchical schematic, 6-layer PCB, project-local symbol and footprint libraries, JLCPCB 6-layer stackup/DFM rules, and complete LCSC/MPN/Datasheet BOM fields with 0 ERC/DRC/parity violations.
    [rp3a-mini-power.kicad_sch, rp3a0-mini-gpio.kicad_sch, rp3a0-mini-hdmi.kicad_sch, rp3a0-mini-misc.kicad_sch, rp3a0-mini-wireless-sd.kicad_sch, rp3a0-mini.kicad_pcb, rp3a0-mini.kicad_sch]
2026-10-20 feat(pcb): add JLCPCB manufacturing exporter, PyTest suite, and documentation
    Add export_manufacturing.py, 16-point PyTest hardware verification suite, 3D passive models, lower-left AuxOrigin, and project READMEs.
    [rp3a0-mini.kicad_pcb]
2026-10-20 fix(pcb): update 19.2MHz crystal load caps to 27pF, add PCB title block, and export JLCPCB BOM/CPL
    Update C6 and C9 from 18pF to 27pF (0402CG270J500NT, LCSC C1557) to provide 18.0 pF effective load capacitance for Y1 (ECS-192-18-33-JGN-TR), add PCB title_block metadata, and configure export_manufacturing.py with JLCPCB_CORRECTIONS and tracked pcb/jlcpcb/ BOM/CPL outputs.
    [rp3a-mini-power.kicad_sch, rp3a0-mini-bom.csv, rp3a0-mini.kicad_pcb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]
2026-10-20 fix(pcb): resolve S2/S6/S7 validation findings across BOM, footprints, and 6-layer PCB
    - Swap D1 (KT-0603G, C12624) symbol and PCB pad polarity so Pin 1 (K) connects to STATUS_LED and Pin 2 (A) to 3V3 via R11
    - Replace U2 adjustable LCSC code with fixed 1.25V 500mA VBIAS LDO NCP133AMX125TCG (C603545) matching pinout and footprint
    - Upgrade Y1 (S3219200182080C3, C5380596), U5 (DMN601VK-7, C110498), and R12/R13/R18 (RC0402FR-07240RL, C114755) to stocked JLCPCB parts
    - Expand C0805_NP (C12, C14) inner pad gap to 0.70 mm and set 0 mm solder mask margin on fine-pitch U3 and J2
    - Add D2 cathode bar, F.Fab/F.CrtYd outlines across all footprints, 3 global optical fiducials (FID1-FID3), and In4.Cu GN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
    [rp3a-mini-power.kicad_sch, rp3a0-mini-bom.csv, rp3a0-mini-hdmi.kicad_sch, rp3a0-mini-misc.kicad_sch, rp3a0-mini.kicad_pcb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]
2026-10-20 docs: update root and PCB READMEs with DFM rules, BOM updates, and JLCPCB ordering guide
2026-10-20 docs: add Altium vs KiCad visual comparison renders and final validation summary
    Add side-by-side 3D, 6-layer copper, and hierarchical schematic visual comparisons between the reference Altium Designer 25 project and the KiCad 10.0.4 port, and document the S0-S8 copper-pilot validate results.
2026-10-23 fix(pcb): resize Y1 crystal load caps to 30pF to match 18pF spec (#3)
    Update crystal load capacitors C6 and C9 from 27pF to 30pF (0402CG300J500NT, LCSC C1570) across the schematic, PCB layout, and JLCPCB manufacturing BOM.
    With series capacitance C_series = (30 * 30)/(30 + 30) = 15.0 pF and typical 6-layer stray capacitance C_stray ≈ 2.5–3.0 pF, this yields an effective load capacitance of 17.5–18.0 pF, reconciling the previous documentation discrepancy where 27pF caps yielded only 16.0 pF against the 18pF nominal specification of Y1 (ECS-192-18-33-JGN-TR). Update READMEs and validation documentation accordingly.
    [rp3a-mini-power.kicad_sch, rp3a0-mini-bom.csv, rp3a0-mini.kicad_pcb]
